AdrianFornes/AQUAPUREX/README.md

# Proyecto Final Diseño de Sistemas Roboticos.
## Descripcion del producto  
El robot de limpieza de cuerpos de agua representa un avance significativo en la lucha contra la contaminaci ́on acu ́atica. Su dise ̃no compacto y su eficiente sistema de propulsi ́on lo hacen ideal para operar en una variedad de entornos acuáticos, desde peque ̃nos estanques hasta grandes cuerpos de agua como r ́ıos y lagos.
Una de las características m ́as destacadas de este robot es su capacidad de recoger y almacenar la basura superficial del agua de manera efectiva y autom ́atica. Cuando los motores se activan y el robot comienza su trayectoria, se inicia autom ́aticamente el proceso de recolecci ́on, lo que garantiza una limpieza continua y sin interrupciones.
Adem ́as de su capacidad de recolecci ́on, el robot est ́a equipado con un avanzado sistema de navegaci ́on semiaut ́onoma. Utilizando tecnolog ́ıas como GPS, c ́amaras y algoritmos de planificaci ́on de ruta, el robot puede evitar obst ́aculos y mantener una trayectoria eficiente de recolecci ́on, maximizando as ́ı su rendimiento y eficacia.
Para garantizar su operaci ́on aut ́onoma durante per ́ıodos prolongados, el robot cuenta con un sistema de energ ́ıa confiable y duradero. Esto puede incluir bater ́ıas recargables que se alimentan mediante energ ́ıa solar, lo que asegura una operaci ́on sostenible y respetuosa con el medio ambiente.
En conjunto, el robot de limpieza de cuerpos de agua ofrece una soluci ́on completa y efectiva para abordar el problema de la contaminaci ́on acu ́atica. Su capacidad de recolecci ́on automatizada, su avanzado sistema de navegaci ́on y su operaci ́on aut ́onoma lo convierten en una herramienta invaluable para la preservaci ́on de nuestros recursos h ́ıdricos y la protecci ́on de la vida acu ́atica.

## Caracteristicas principales del Producto

El barco de limpieza de cuerpos de agua está diseñado con dimensiones compactas de 80 cm de largo, 80 cm de ancho y 40 cm de alto, lo que permite una fácil maniobrabilidad en una variedad de entornos acuáticos. Equipado con dos motores para la propulsión, este barco ofrece una capacidad de carga de hasta 5 kg, lo que le permite recolectar una amplia gama de desechos y residuos flotantes de manera efectiva.

Para garantizar un funcionamiento sostenible, el barco de limpieza de cuerpos de agua se alimenta mediante una batería de 12 voltios con una capacidad de 1 amperio, lo que proporciona una fuente de energía eficiente y respetuosa con el medio ambiente. Su construcción robusta incluye un esqueleto de PVC de 3/4 de pulgada para una base sólida, mientras que el casco está recubierto de madera para mejorar la durabilidad y el aspecto estético del barco.

La estabilidad en el agua está garantizada gracias al sistema de flotación de unicel de 5 cm, que proporciona una base estable y equilibrada durante la operación. Para facilitar su control y automatización, el barco de limpieza de cuerpos de agua utiliza un puente H y un Arduino Uno, lo que permite un funcionamiento semiautónomo y una navegación precisa.

La interfaz de usuario intuitiva, desarrollada mediante una aplicación en MIT App Inventor, ofrece botones de dirección (derecha, izquierda y avanzar) para facilitar la navegación y el control del barco. Además, la inclusión de un módulo HC-05 permite la comunicación Bluetooth, lo que posibilita el control remoto del barco a través de dispositivos móviles compatibles, aumentando su versatilidad y facilidad de uso.

## Desarrollo Software

Para la parte del software se realizo una aplicacion que se puede controlar mediante un dispositivo celular, esta aplicacioin es MIT App Inventor la cual es una gran pagina y es muy sencilla de utilizar, para esto se creo una cuenta el esta pagina y de ahi un nuevo proyecto para generar nuestro control remoto.

La primera parte que se configuro fue la interfaz de la app, se decidio que fuera de forma horizontal, que tuviera tres botones simples para su utilizacion, se configuro los botones de la manera en la que se ve en la siguiente imagen.
 <p align="center">
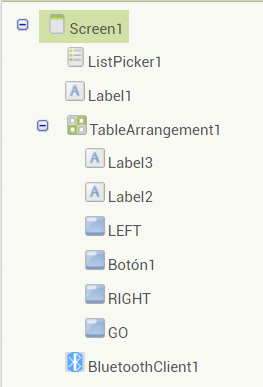
[picture p1: ship/display{.png]
  
</p>
Con estos bloques de botones pudimos definir cualles iban a ser nuestros controles, se les puso una flecha como imagen por pura representacion y el texto de abajo indicando que flecha mueve cada motor, tambien se afrea un boton "GO" el cual significa que los dos motores se prenden al mismo tiempo para avanzar. Por otra parte se hizo una coneccion Bluetooth para poderse conctar con el hc- 05 que esta conectado con el arduino, tambien se agrego una lista de dispósitivos bluetooth para poder conectarla aplicacion con el robot. Como se puede observar en la sigueinte imagen la distribuucion del layout de la app.
<p align="center">
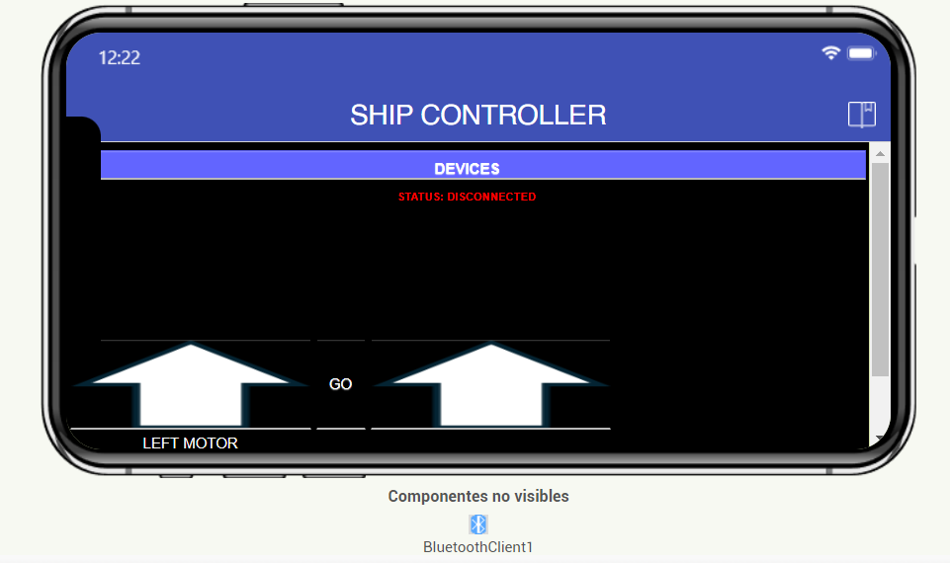
[picture p2: ship/bottons.png]
  
</p>

Despues de que se realizo el layout de la app, se deben de programar los bloques necesarios para poder controlar los motores, en este caso primero se hizo una conexion bluetooth en bloques donde se especifica la conexiion simple entre el robot y el telefono como se muestra en la siguiente imagen.

<p align="center">
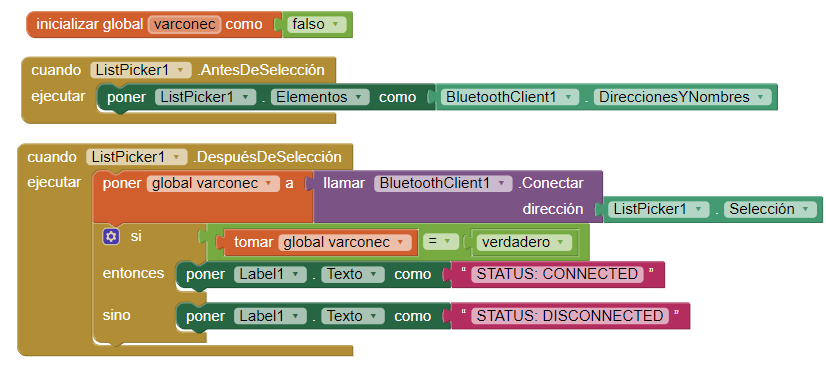
[picture p3: ship/conexion bt.png]
  
</p>

Despues de uqe se haya logrado la conexion se programaron 3 bloques de codigo en el cual se especifica el motor derecho, izquierdo y el GO, cabe recalcar que tambien se configuraron como es que se van a presionar los botones, en este caso fue un mantener y soltar en cada yuno de ellos para que el ususario tuviera el control sin algun tipo de problema. En cada uno de estos programas hacemos que imprima una letra para podersela mandar al programa del arduino y asi tener una reaccion al momento de presionar los botones, esta tiene que ser diferente para que no tengamos problema en el programa de arduino. En la siguientes imagenes se mostraran los bloques necesarios para programar de manera eficiente el control.

<p align="center">
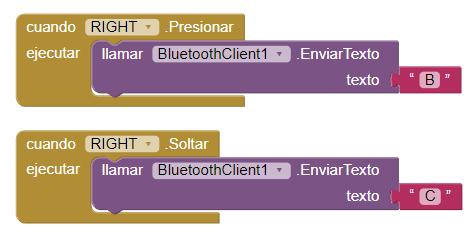
[picture p4: ship/derecho.png]
  
</p>

<p align="center">
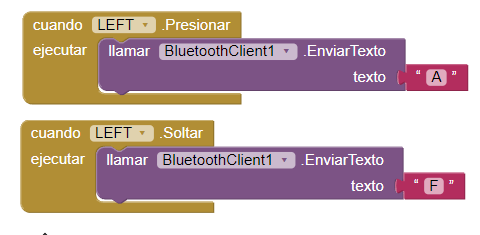
[picture p5: ship/izquierdo.png]
  
</p>

<p align="center">
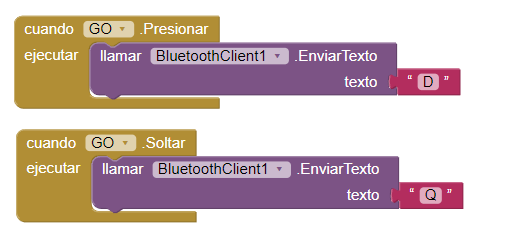
[picture p6: ship/ambos.png]
  
</p>

## Construcción

Para construir el robot acuatico, fue necesario diseñar su construcción, teniendo en cuenta los materiales a usar, para ello se llevaron a cabo los siguientes diseños:







El diseño permite al barco almacenar basura en su interior mientras sigue avanzando, permitiendole limpiar las zonas asignadas sin que los desechos se esparzan.

La construcción se llevó a cabo con material reciclado, tomando en cuenta la flotabilidad, estabilidad y el peso. Por eso se decidio usar una base de unicel y tuvos de PVC para que tuvieran una flotabilidad rigida, al unicel se le aplico un sellador para que no tuviera complicaciones con el agua (hinchamiento, absorción del agua, etc.), los tuvos de PVC fueron unidos y sellados de tal manera que aunque la base del unicel no resistiera, el aire en los tubos permita una flotabilidad y estabilidad en el barco, además de que cumple con la función de esqueleto y soporte principal del robot.







Para la construcción del casco del barco se prediseño en carton:







Una vez calculada la distancia de la borda se procedio a instalarlo en material de triplay par una mejor rigides, flexibilidad y ligereza en la estructura.







Posterior a ello se hizo una prueba para comprobar su flotabilidad:





A pesar de ser excitosa la prueba, optamos por perforar la madera en las partes laterales, esto con motivo de tener una mejor aerodinamica, reducir peso y por diseño. Con los cambios realizados, el robot pudó cargar y almacenar más peso para su operatividad, siendo flexible al momento de cambiar algun componente u optimizarlo.



Una vez el diseño funcionara de manera excitosa, se le acoplo el circuito, soldando y pegando componentes para su fiabilidad.







Nos encontramos con muchos problemas y obstaculos en el proceso de instalacion del circuito, uno de ellos fueron los ejes que conectan las helices con los motores por falta de rigidez, se optó por cambiar esa pieza a una mas robustas, insertando un pedazo de metal en el eje para una mejor rigidez. Otro obstaculo fue en la instalación de los servomotores al casco del robot, al momento de compilar el programa y observar el comportamiento de los motores, se analizó criticamente que la vibración de ambos servomotores afectaban el funcionamiento de las helices y conexión al arduino, se optó por ponerle cinta de aislar pero al momento de probar su resistencia, la cinta no pudó resistir y la solución que le dimos fue una perforación con un rotomartillo para perforar el triplay y aplicar unos sinchos para un mejor control.





Para una ultima prueba de funcionalidad de todo el proyecto se desplegó en una piscina con inclinación para poner a prueba el torque de los motores, la flotabilidad y la fiabilidad en los ejes.

https://github.com/AdrianFornes/AQUAPUREX/assets/132616532/4b5de7d5-101a-42e0-96de-4a74aff5eb6a

El día de la presentación se dificulto la conexión entre dispositivos debido a la mala señal de internet pero se pudo resolver de manera eficiente, para ello se cargaron dos programas para 2 las dos demostraciones, uno con el control de la aplicación y uno autonomo que cumplia con una rutina sencilla de un rectangulo, a continuación las pruebas de la demostración:

https://github.com/AdrianFornes/AQUAPUREX/assets/132616532/5c35d5ec-fdd1-4ef8-8b59-79b6c51ed80c

https://github.com/AdrianFornes/AQUAPUREX/assets/132616532/10b5c68b-f21c-44ea-8157-4843d8c3a589

En la demostracion el robot demostro su eficiencia y fiabilidad en su funcionamiento por lo que damos como un exito el trabajo realizado.

Para la parte autonoma se desarrolló en el software Arduino IDE, donde realiza una rutina en forma rectangular 

*Checar anexo Rectangulo_Autonomo.ino*
